primanafisman/THESIS_FULL-BRIDGE-DC-MOTOR-CONTROLLER/README.md

# Hi there

These are prima's thesis.

I'm working at Fullbridge DC Motor Controller. Create model, hardware, and firmware to controll the steering DC Motor

Let's have a look!

Any further improvements are always widthly open
