primanafisman/THESIS_FULL-BRIDGE-DC-MOTOR-CONTROLLER/Dokumen/foto/250pwm.png

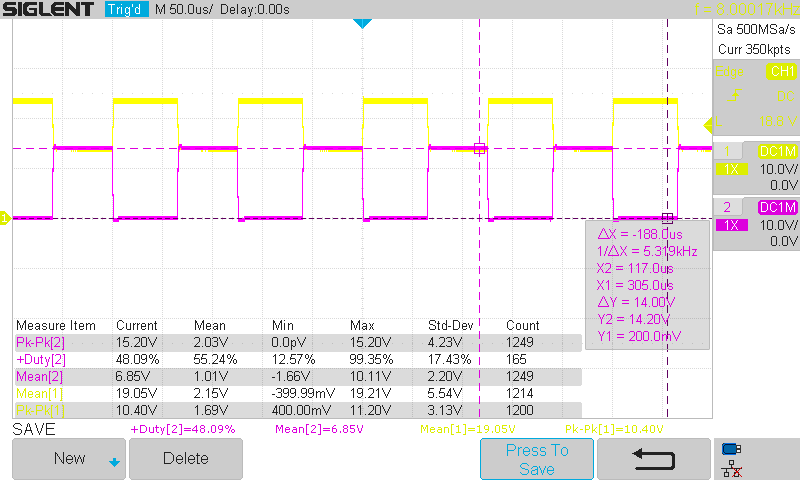
Dokumen/foto/250pwm.png
