primanafisman/THESIS_FULL-BRIDGE-DC-MOTOR-CONTROLLER/Dokumen/foto/PNG250.png

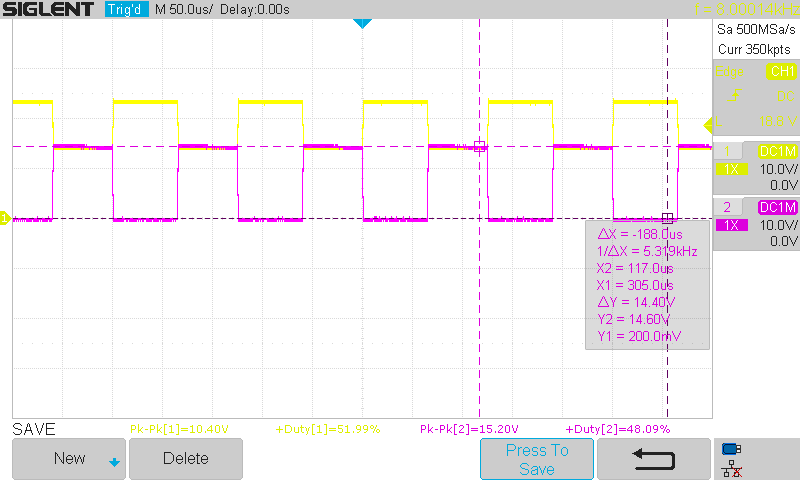
Dokumen/foto/PNG250.png
