primanafisman/THESIS_FULL-BRIDGE-DC-MOTOR-CONTROLLER/Dokumen/foto/SDS00001.png

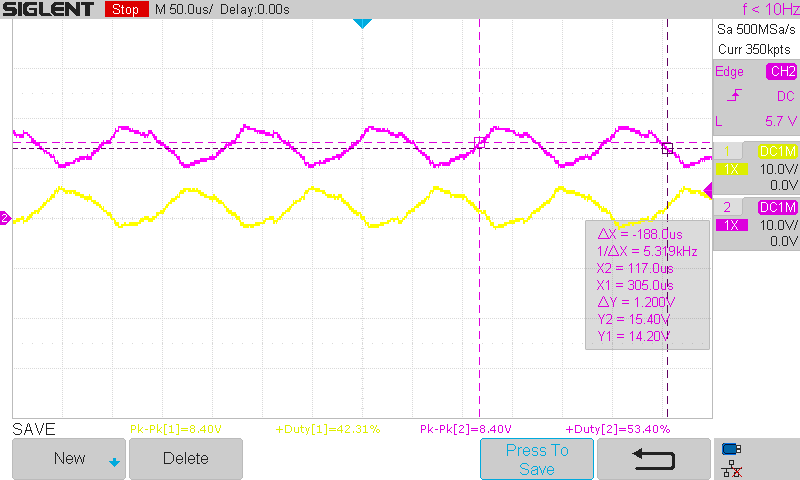
Dokumen/foto/SDS00001.png
