primanafisman/THESIS_FULL-BRIDGE-DC-MOTOR-CONTROLLER/Dokumen/foto/SDS00002.png

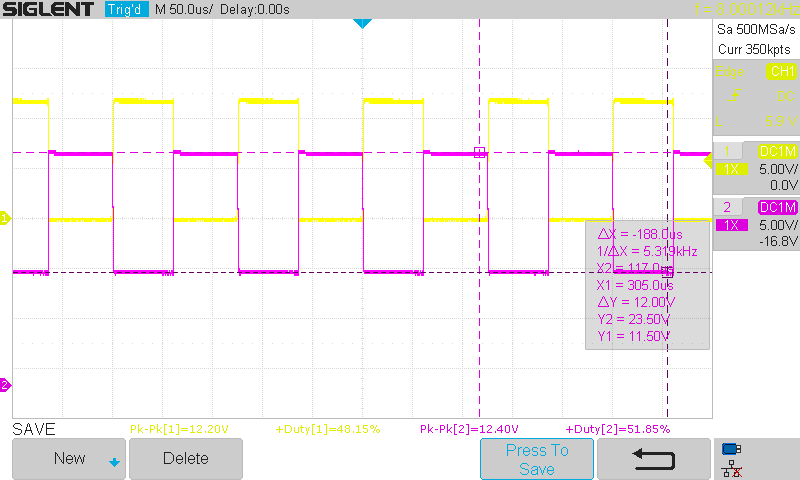
Dokumen/foto/SDS00002.png
