primanafisman/THESIS_FULL-BRIDGE-DC-MOTOR-CONTROLLER/Controller 48V 20A bobokVer/PCB/Controller48V/B2405S-2W/B2405S-2W.step

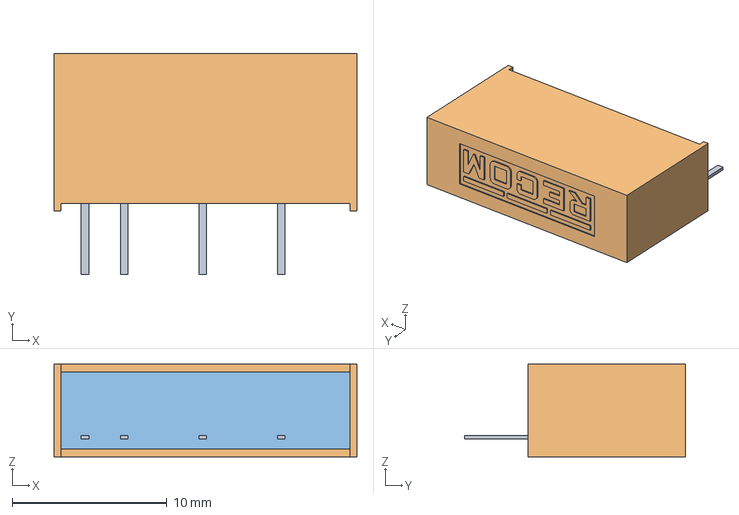
[picture p6: CAD file, 2026-02-03]
Controller 48V 20A bobokVer/PCB/Controller48V/B2405S-2W/B2405S-2W.step
19.6 x 14.3 x 6.00 mm
