primanafisman/THESIS_FULL-BRIDGE-DC-MOTOR-CONTROLLER/Controller 48V 20A bobokVer/PCB/Controller48V/BS1212S/SIP4_B_S-1WR3_MNS.step

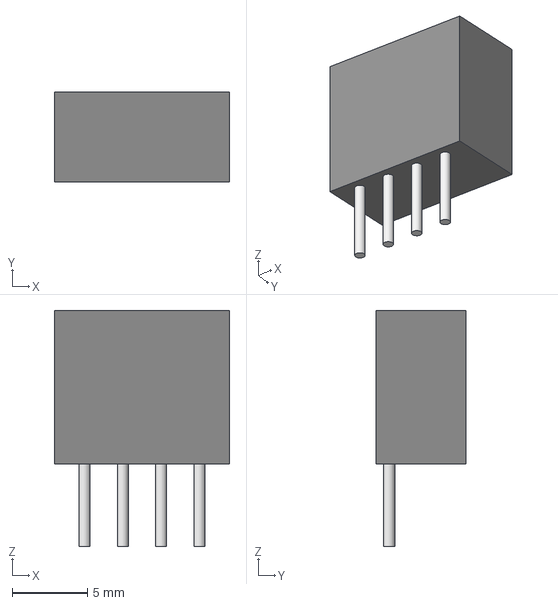
[picture p7: CAD file, 2026-02-03]
Controller 48V 20A bobokVer/PCB/Controller48V/BS1212S/SIP4_B_S-1WR3_MNS.step
11.6 x 5.99 x 15.6 mm
