primanafisman/THESIS_FULL-BRIDGE-DC-MOTOR-CONTROLLER/Controller 48V 20A bobokVer/PCB/Controller48V/TLP350/TLP350.step

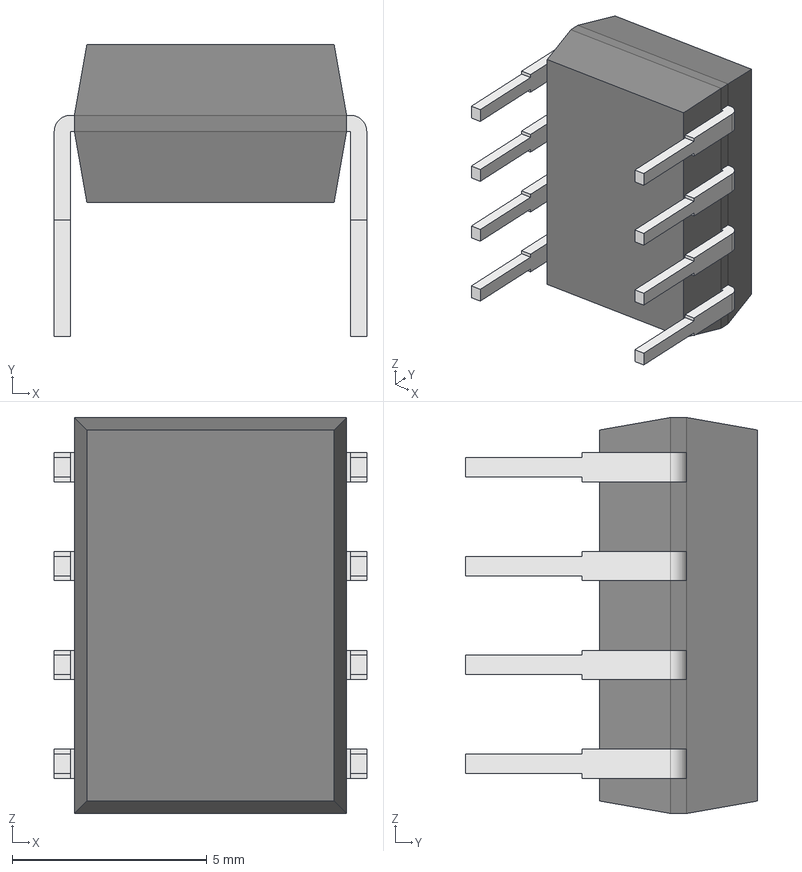
[picture p8: CAD file, 2026-02-03]
Controller 48V 20A bobokVer/PCB/Controller48V/TLP350/TLP350.step
8.04 x 7.51 x 10.2 mm
Body001 (Mirror #1) x 5
