primanafisman/THESIS_FULL-BRIDGE-DC-MOTOR-CONTROLLER/Controller 48V 20A bobokVer/PCB/PrechRes/PrechRes/resistor_100w_aluminum_finned.stp

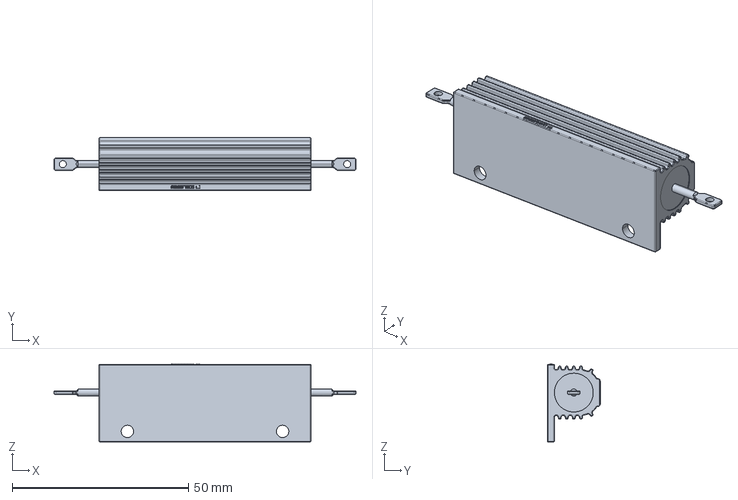
[picture p9: CAD file, 2026-02-03]
Controller 48V 20A bobokVer/PCB/PrechRes/PrechRes/resistor_100w_aluminum_finned.stp
85.6 x 15.1 x 22.1 mm
