primanafisman/THESIS_FULL-BRIDGE-DC-MOTOR-CONTROLLER/Controller 48V 20A bobokVer/PCB/PrechRes/PrechRes/VOM1271/VOM1271T.step

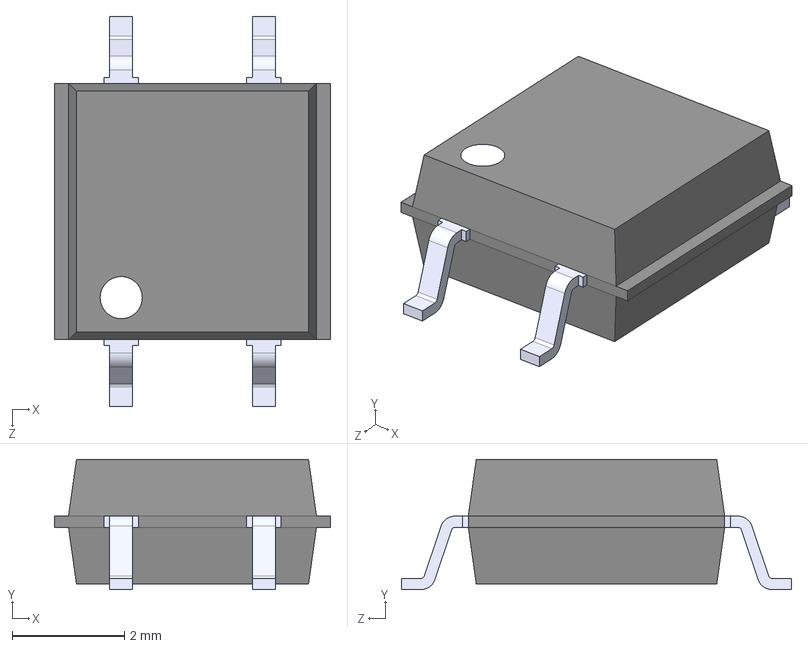
[picture p10: CAD file, 2026-02-03]
Controller 48V 20A bobokVer/PCB/PrechRes/PrechRes/VOM1271/VOM1271T.step
4.92 x 2.32 x 6.95 mm
