primanafisman/THESIS_FULL-BRIDGE-DC-MOTOR-CONTROLLER/Controller 48V 20A bobokVer/PCB/Controller48V/P_16,4x15,8x34,8.STEP

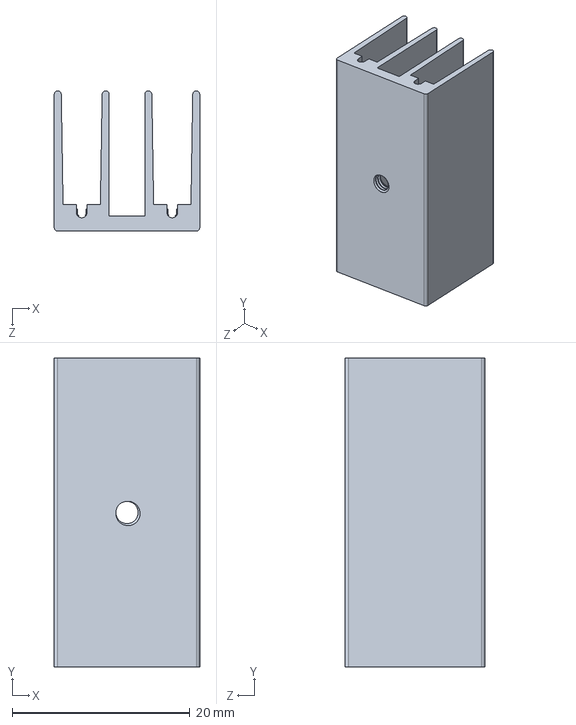
[picture p11: CAD file, 2026-02-03]
Controller 48V 20A bobokVer/PCB/Controller48V/P_16,4x15,8x34,8.STEP
16.4 x 34.8 x 15.8 mm
