primanafisman/THESIS_FULL-BRIDGE-DC-MOTOR-CONTROLLER/Controller 48V 20A bobokVer/PCB/PrechRes/PrechRes/PrechResv2.step

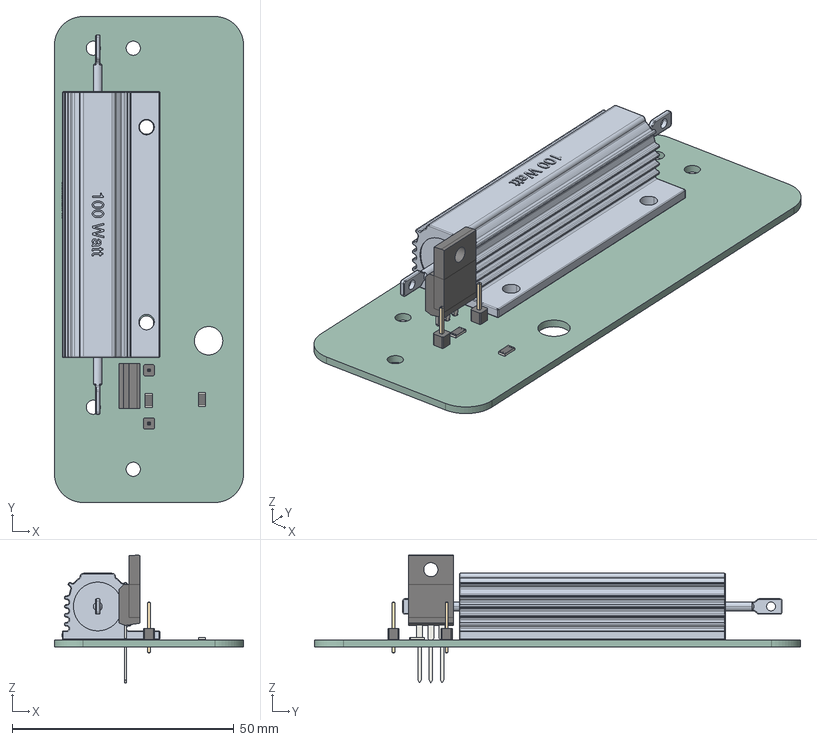
[picture p12: CAD file, 2026-02-03]
Controller 48V 20A bobokVer/PCB/PrechRes/PrechRes/PrechResv2.step
42.7 x 109.7 x 28.9 mm
PinHeader_1x01_P2.54mm_Vertical x 2
resistor_100w_aluminum_finned
R_1206_3216Metric x 2
TO-220F-3_Vertical
PrechResv2_PCB
