primanafisman/THESIS_FULL-BRIDGE-DC-MOTOR-CONTROLLER/Controller 48V 20A bobokVer/PCB/Controller48V/ControlMikon.step

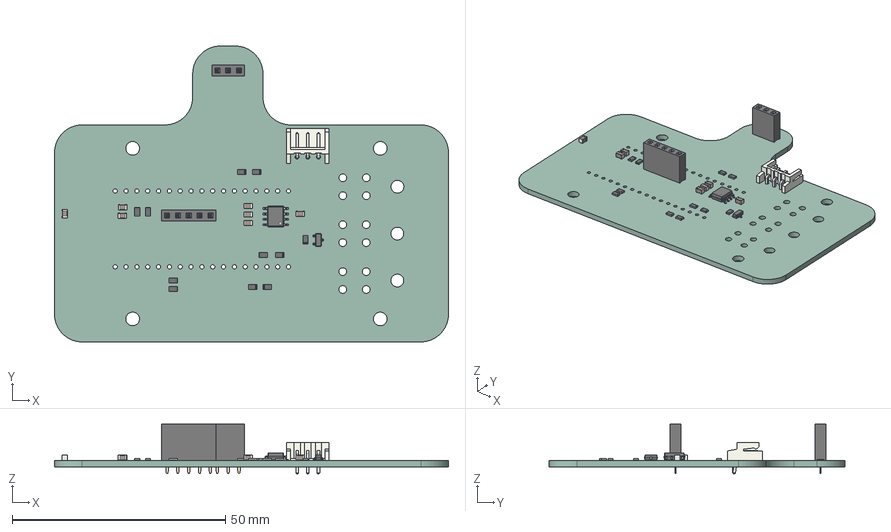
[picture p13: CAD file, 2026-02-03]
Controller 48V 20A bobokVer/PCB/Controller48V/ControlMikon.step
92.4 x 69.4 x 11.7 mm
C_0805_2012Metric x 7
R_0805_2012Metric x 11
SOT-23
PinSocket_1x03_P2.54mm_Vertical
PinSocket_1x05_P2.54mm_Vertical
SOIC-8_3.9x4.9mm_P1.27mm
JST_EH_S3B-EH_1x03_P2.50mm_Horizontal
ControlMikon_PCB
