primanafisman/THESIS_FULL-BRIDGE-DC-MOTOR-CONTROLLER/Controller 48V 20A bobokVer/PCB/Controller48V/C_TO-220x2_36,5x17x25.STEP

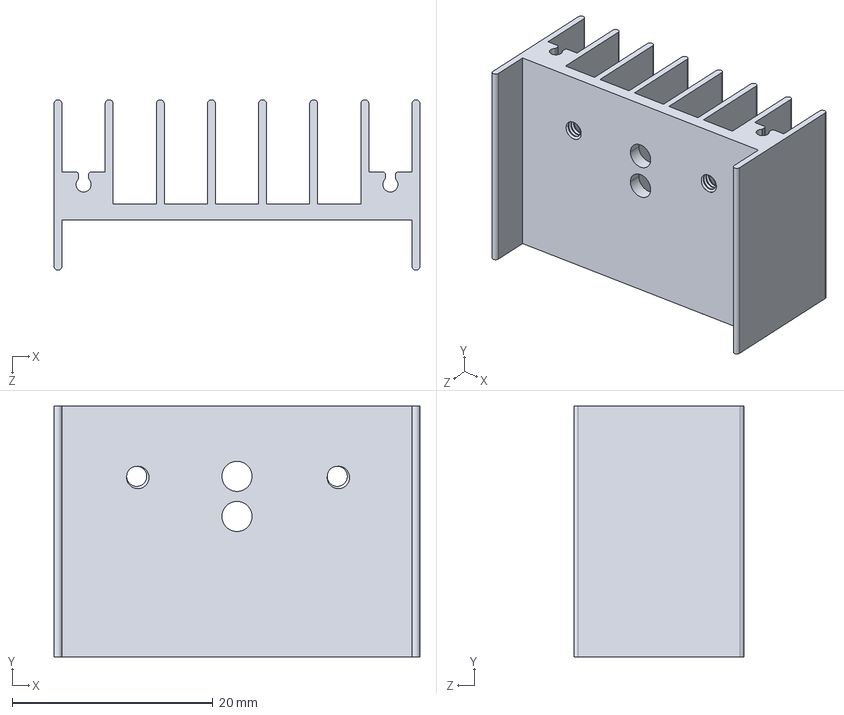
[picture p14: CAD file, 2026-02-03]
Controller 48V 20A bobokVer/PCB/Controller48V/C_TO-220x2_36,5x17x25.STEP
36.5 x 25.0 x 17.0 mm
