primanafisman/THESIS_FULL-BRIDGE-DC-MOTOR-CONTROLLER/Controller 48V 20A bobokVer/PCB/Controller48V/Heatsink_60x20x40.STEP

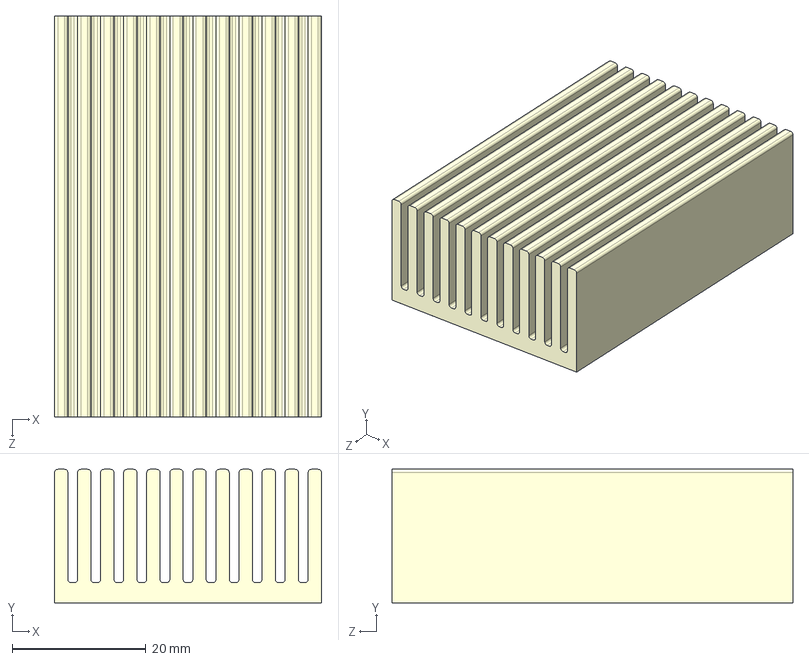
[picture p15: CAD file, 2026-02-03]
Controller 48V 20A bobokVer/PCB/Controller48V/Heatsink_60x20x40.STEP
40.0 x 20.0 x 60.0 mm
