primanafisman/THESIS_FULL-BRIDGE-DC-MOTOR-CONTROLLER/Controller 48V 20A bobokVer/PCB/PrechRes/PrechRes/gerberPrechRes/PrechResv2.pdf

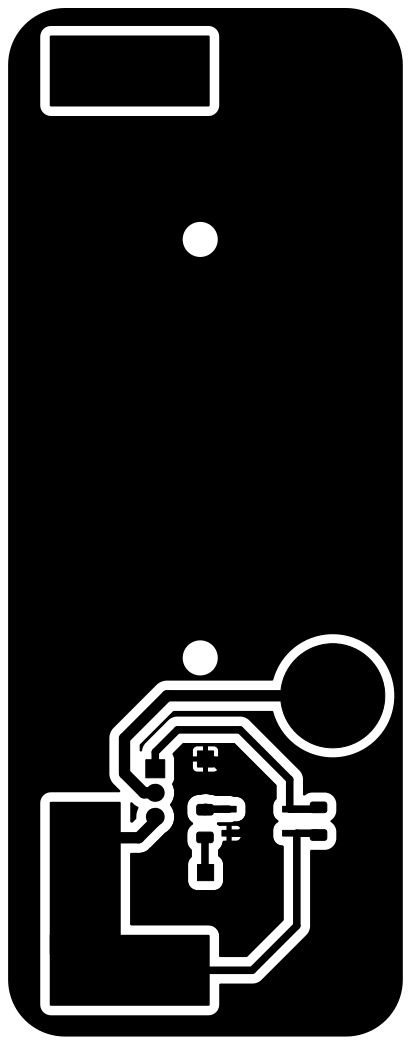
[picture p16: page 1]

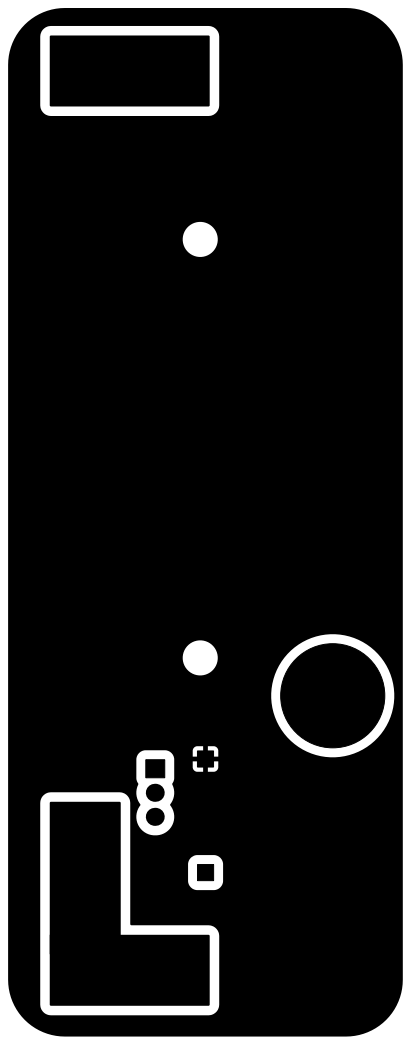
[picture p17: page 2]

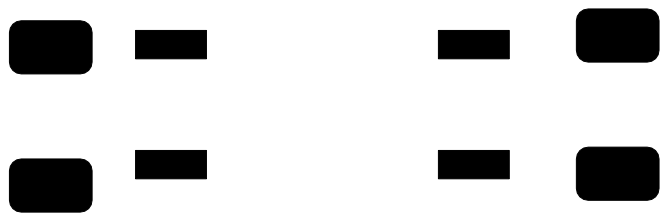
[picture p18: page 3]

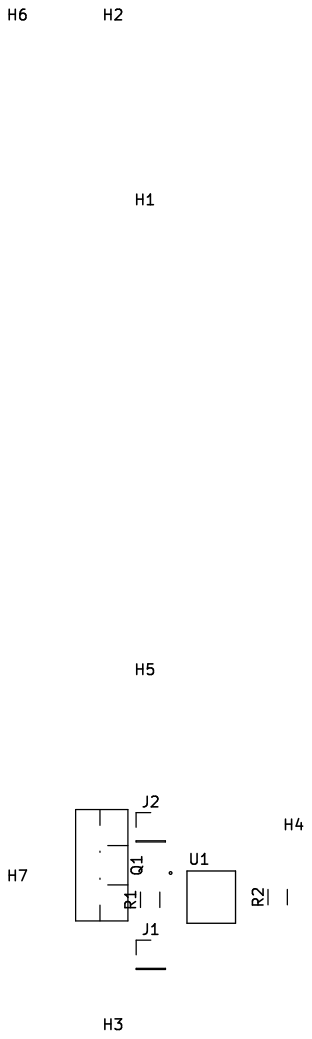
[picture p19: page 5]

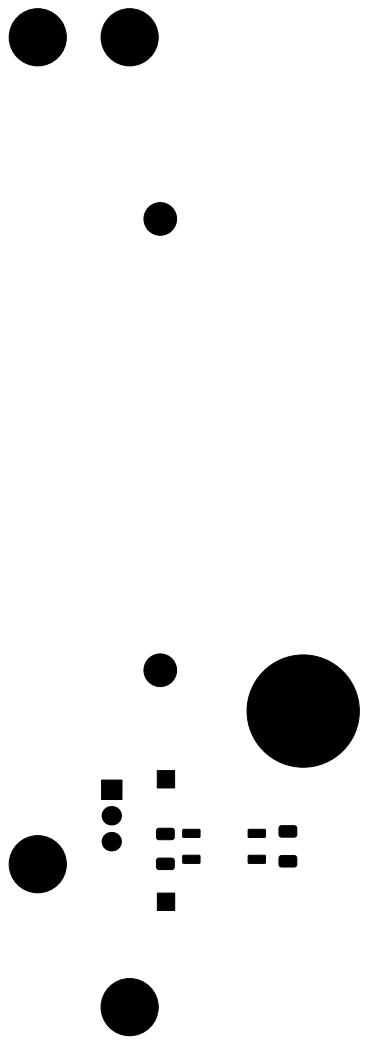
[picture p20: page 7]

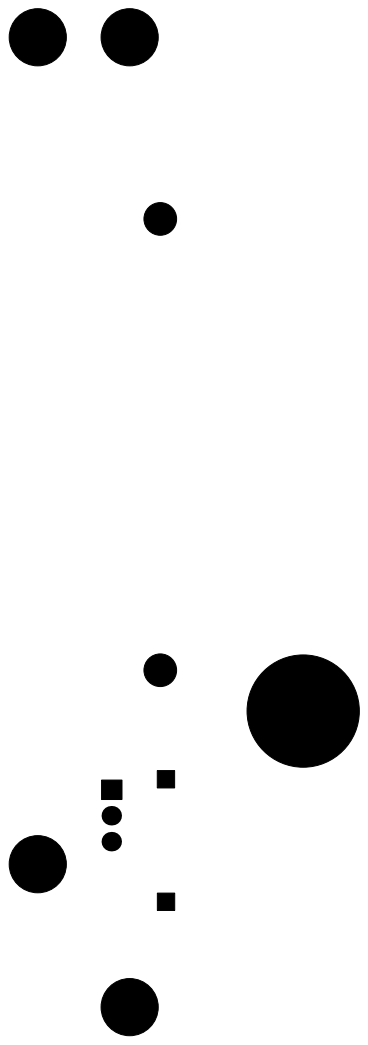
[picture p21: page 8]

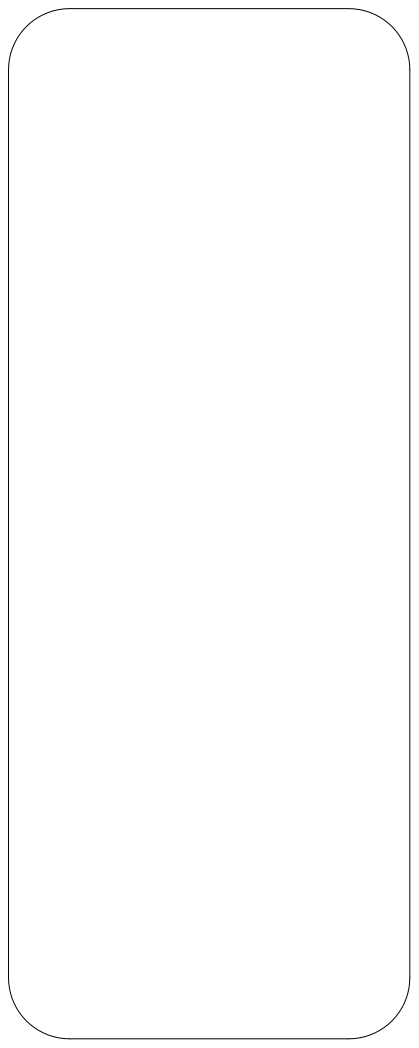
[picture p22: page 9]
