primanafisman/THESIS_FULL-BRIDGE-DC-MOTOR-CONTROLLER/Controller 48V 20A bobokVer/PCB/ControlMikon/ControlMikon.kicad_pcb

## KiCad design Controller 48V 20A bobokVer/PCB/ControlMikon/ControlMikon.kicad_pcb (2026-02-03)

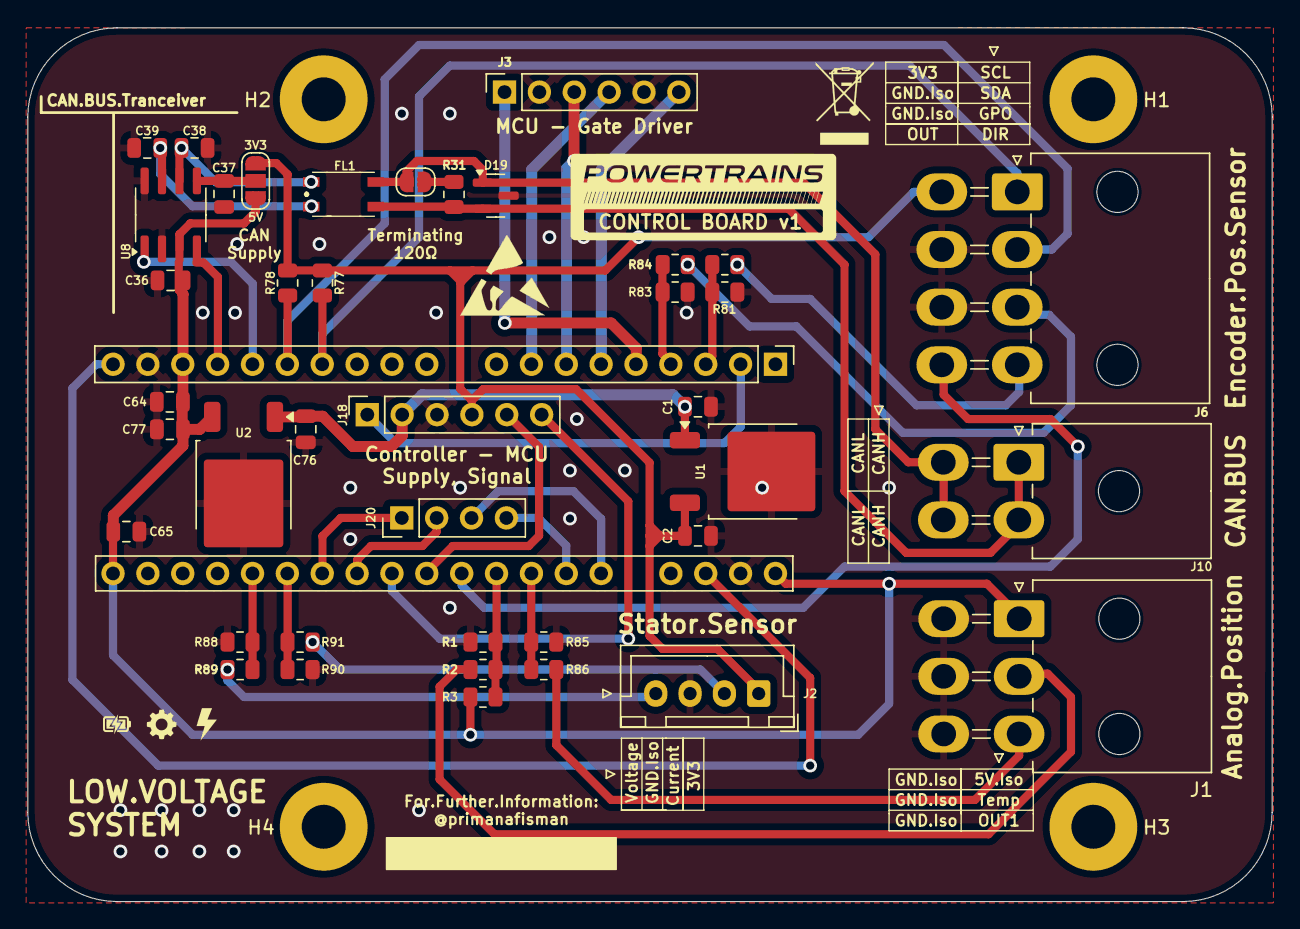
[picture p23: board ControlMikon.kicad_pcb from above]

Board: 2 copper layers, 90.7 x 63.7 mm, 45 parts (0 on the bottom side), 39 nets.

Parts:
C1, C76: 330nF; C_0805_2012Metric
C2, C64, C65, C77: 100nF; C_0805_2012Metric
C36, C37: 1uF; C_0805_2012Metric
C38, C39: 220pf; C_0805_2012Metric
D19: PESD1CAN; SOT-23
FL1: DLW43MH201XK2K; DLW43
H1, H2, H3, H4: MountingHole; MountingHole_3.2mm_M3_Pad
J1: AnalogPosition; Molex_Mini-Fit_Jr_5569-06A2_2x03_P4.20mm_Horizontal
J2: From Current & Voltage Sense; JST_XH_B4B-XH-A_1x04_P2.50mm_Vertical
J3: Conn_01x06; PinSocket_1x06_P2.54mm_Vertical
J5: Selector Termination; SolderJumper-2_P1.3mm_Open_RoundedPad1.0x1.5mm
J6: Conn_01x08; Molex_Mini-Fit_Jr_5569-08A2_2x04_P4.20mm_Horizontal
J10: CANBUS; Molex_Mini-Fit_Jr_5569-04A2_2x02_P4.20mm_Horizontal
J18: Input Power; PinSocket_1x06_P2.54mm_Vertical
J20: AnalogPosition; PinHeader_1x04_P2.54mm_Vertical
JP5: Logic Level; SolderJumper-3_P1.3mm_Open_RoundedPad1.0x1.5mm_NumberLabels
R1, R2, R3, R77, R78, R81, R82, R83, R84, R85, R86: 1k; R_0805_2012Metric
R31: 120; R_0805_2012Metric
R88, R90: 3k3; R_0805_2012Metric
R89, R91: 1k8; R_0805_2012Metric
U1, U2: LM78M05_TO252; TO-252-2
U8: MCP2562-H-SN; SOIC-8_3.9x4.9mm_P1.27mm
U23: STM32F103CBTx; STM32F103CBT6

Connections:
3V3: C2.2, J2.1, J6.5, J18.4, JP5.3 (B), R77.1, R78.1, U1.3 (VO)
5VDigital_Isolated: C36.1, C64.1, C65.1, C77.2, J1.1, JP5.1 (A), R3.2, U2.3 (VO), U8.3 (VDD), U23.1 (VBAT), U23.24 (VDD), U23.36 (VDD)
12V_Isolated: C1.2, C76.2, J18.2, U1.1 (VI), U2.1 (VI)
/PRECHARGE_FINISH_TRIG: J18.1, U23.26 (PB13)
Aux1: J18.6, U23.14 (ADC1_IN4)
Aux2: J18.5, U23.15 (ADC1_IN5)
Aux3: R1.2, R2.1, R3.1, U23.17 (ADC1_IN7)
BATTV_Out: J20.1, U23.12 (ADC1_IN2)
CAL_L: C38.1, FL1.4, U8.6 (CANL)
CAN_H: C39.1, FL1.1, U8.7 (CANH)
CAN_H_Out: D19.2, FL1.2, J10.1, J10.2, R31.2
CAN_L_Out: D19.1, FL1.3, J5.1, J10.3, J10.4
CAN_Rx: U8.4 (RXD), U23.46 (CAN_TX)
CAN_Tx: U8.1 (TXD), U23.45 (CAN_RX)
CTRLV_Out: J20.2, U23.13 (ADC1_IN3)
CurrentSensor: R90.2, R91.1, U23.11 (ADC1_IN1)
DIR: R81.2, R82.1, U23.27 (PB14)
FinishLV: J20.4, U23.19 (PB1)
GND_Isolated: C1.1, C2.1, C36.2, C37.2, C38.2, C39.2, C64.2, C65.2, C76.1, C77.1, D19.3, J1.4, J1.5, J1.6, J2.3, J3.2, J3.5, J6.6, J6.7, J18.3, R1.1, R81.1, R83.1, R85.1, R88.1, R90.1, U1.2 (GND), U2.2 (GND), U8.2 (VSS), U8.8 (STBY), U23.8 (VSSA), U23.23 (VSS)
GPO: R83.2, R84.1, U23.28 (PB15)
HIN1_Mikon: J3.1, U23.29 (TIM1_CH1)
HIN2_Mikon: J3.3, U23.31 (TIM1_CH3)
LIN1_Mikon: J3.6, U23.30 (TIM1_CH2)
LIN2_Mikon: J3.4, U23.32 (TIM1_CH4)
unnamed: J1.2, R2.2
unnamed: J1.3, R86.2
unnamed: J2.2, R91.2
unnamed: J2.4, R89.2
unnamed: J5.2, R31.1
unnamed: J6.3, R84.2
unnamed: J6.4, R82.2
unnamed: C37.1, JP5.2 (C), U8.5 (Vio)
unnamed: U23.9 (VDDA), U23.48 (VDD)
Out: J6.8, U23.16 (ADC1_IN6)
Out1: R85.2, R86.1, U23.18 (ADC1_IN8)
Ready: J20.3, U23.20 (PB2)
SCL: J6.1, R77.2, U23.42 (I2C1_SCL)
SDA: J6.2, R78.2, U23.43 (I2C1_SDA)
VoltageSensor: R88.2, R89.1, U23.10 (ADC1_IN0)
