primanafisman/THESIS_FULL-BRIDGE-DC-MOTOR-CONTROLLER/Controller 48V 20A bobokVer/PCB/PrechRes/PrechRes/PrechRes.kicad_pcb

## KiCad design Controller 48V 20A bobokVer/PCB/PrechRes/PrechRes/PrechRes.kicad_pcb (2026-02-03)

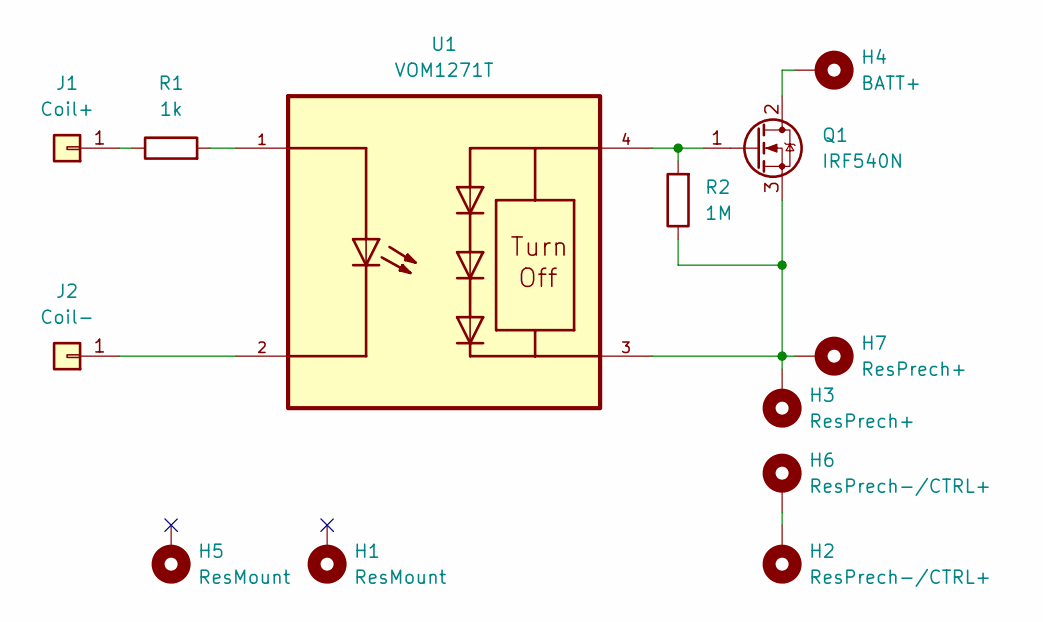
[picture p24: schematic PrechRes.kicad_sch]

Parts:
H1, H5: ResMount; MountingHole_3.2mm_M3
H2, H6: ResPrech-/CTRL+; MountingHole_3.2mm_M3_DIN965_Pad
H3, H7: ResPrech+; MountingHole_3.2mm_M3_DIN965_Pad
H4: BATT+; MountingHole_6.4mm_M6_DIN965_Pad
J1: Coil+; PinHeader_1x01_P2.54mm_Vertical
J2: Coil-; PinHeader_1x01_P2.54mm_Vertical
Q1: IRF540N; TO-220F-3_Horizontal_TabDown
R1: 1k; R_1206_3216Metric
R2: 1M; R_1206_3216Metric
U1: VOM1271T; SOIC254P695X242-4N

Connections:
unnamed: H2.1, H6.1
unnamed: J1.1, R1.1
unnamed: J2.1, U1.2
unnamed: H4.1, Q1.2 (D)
unnamed: Q1.1 (G), R2.2, U1.4
unnamed: H3.1, H7.1, Q1.3 (S), R2.1, U1.3
unnamed: R1.2, U1.1

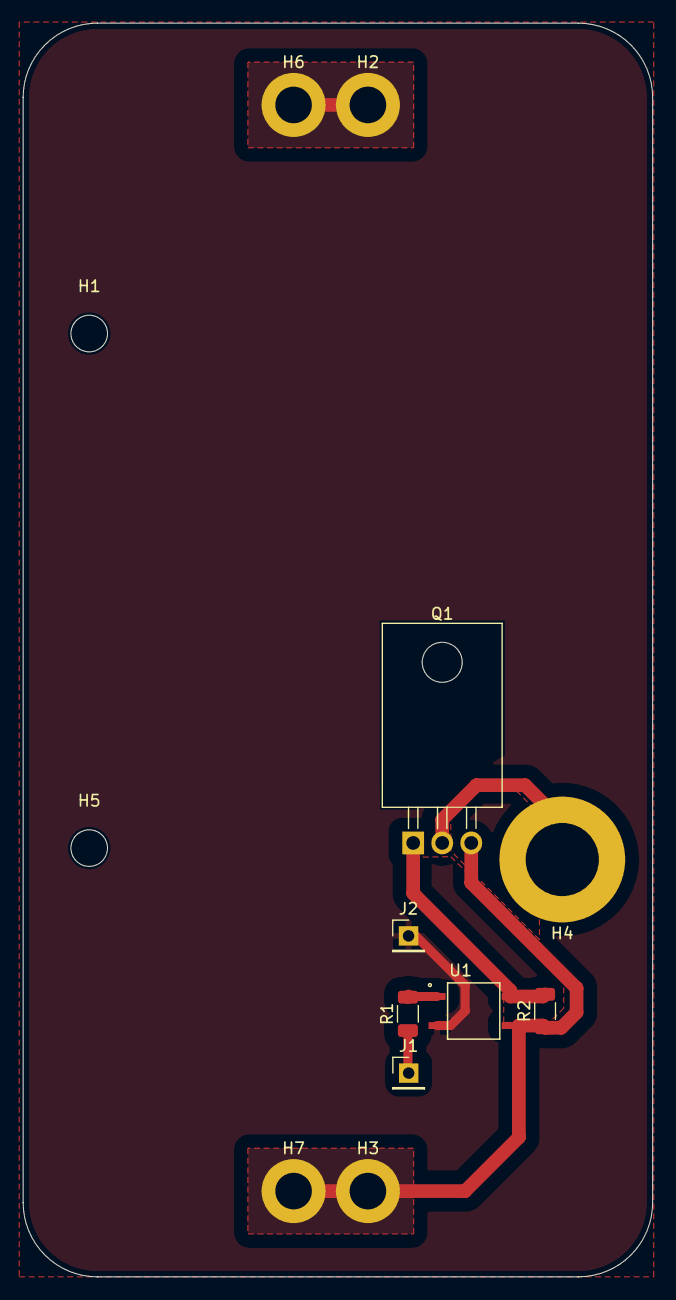
[picture p25: board PrechRes.kicad_pcb from above]

Board: 2 copper layers, 55.1 x 109.7 mm, 13 parts (0 on the bottom side), 7 nets.
