primanafisman/THESIS_FULL-BRIDGE-DC-MOTOR-CONTROLLER/Controller 48V 20A bobokVer/PCB/Controller48V/Controller48V - Copy.kicad_pcb

## KiCad design Controller 48V 20A bobokVer/PCB/Controller48V/Controller48V - Copy.kicad_pcb (2026-02-03)

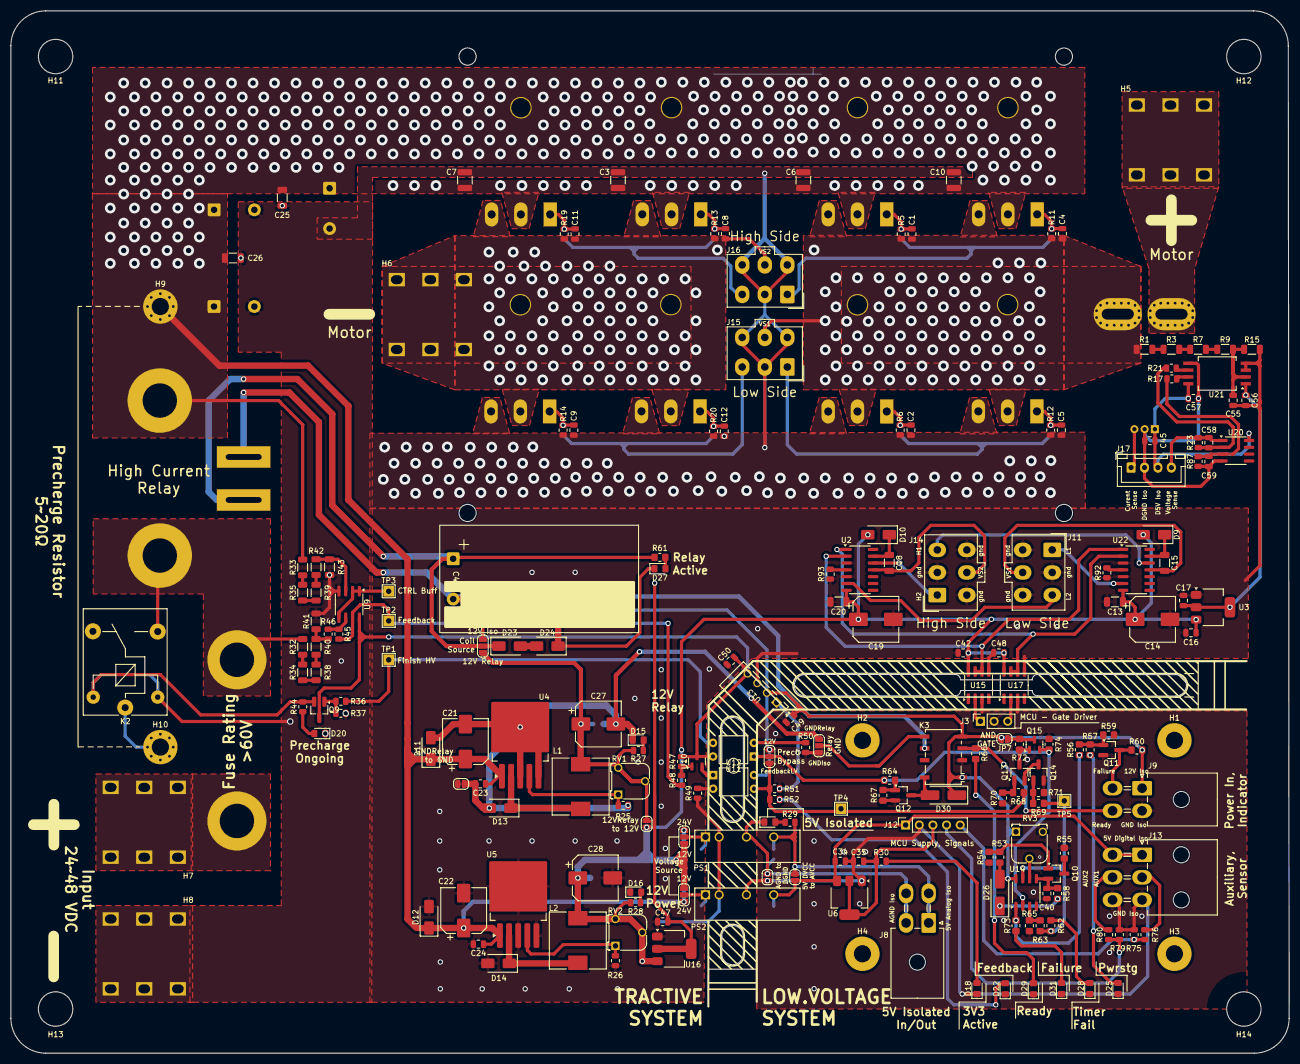
[picture p26: board Controller48V - Copy.kicad_pcb from above]

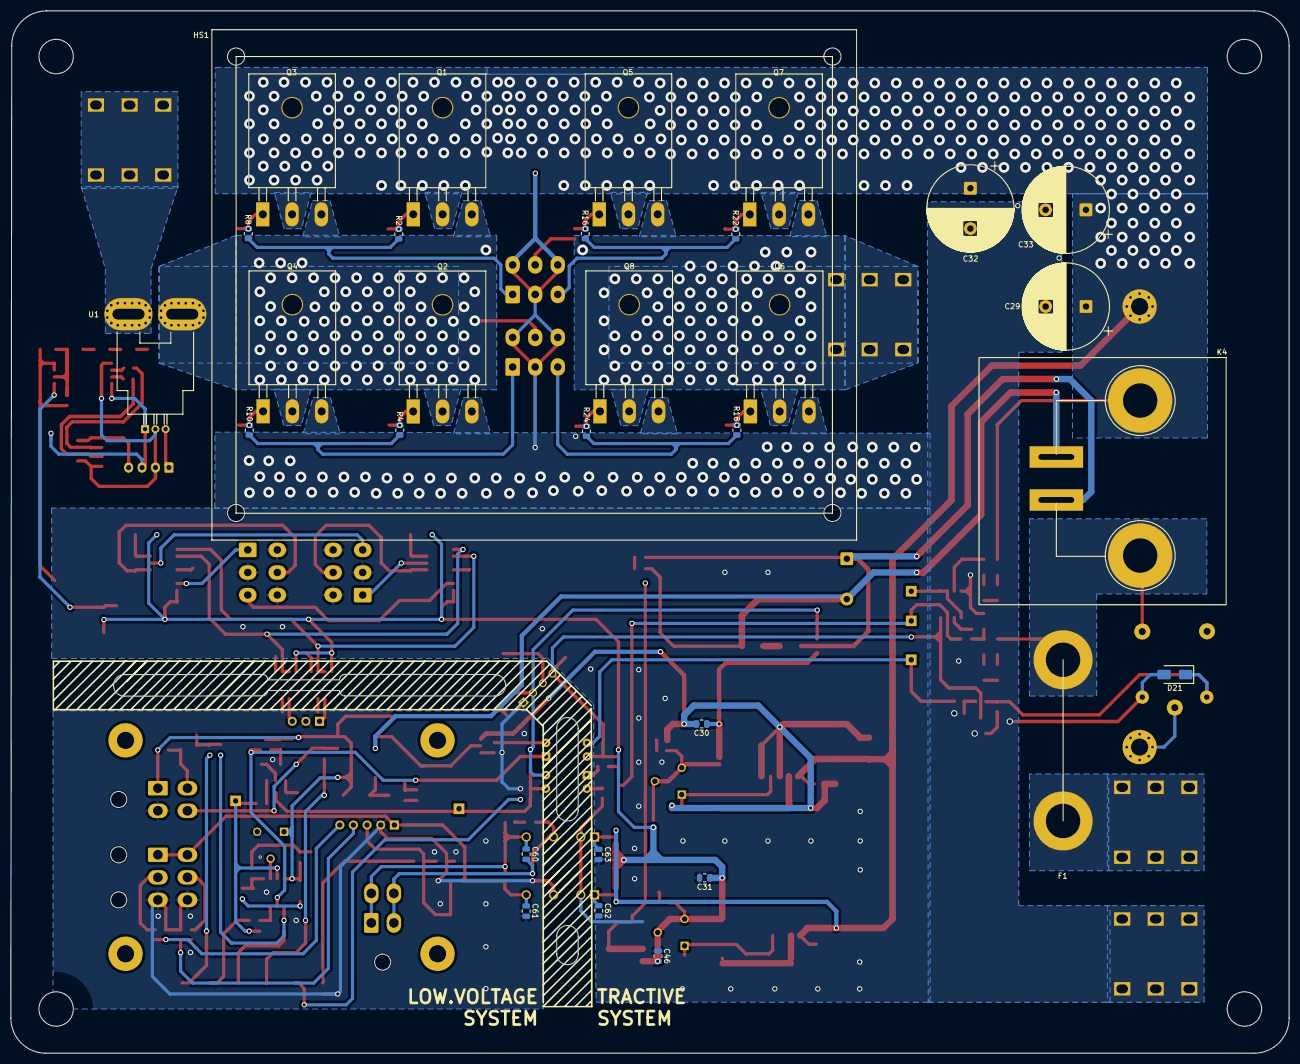
[picture p27: board Controller48V - Copy.kicad_pcb from below]

Board: 2 copper layers, 237.9 x 194.0 mm, 239 parts (31 on the bottom side), 121 nets.

Parts:
C1, C2, C4, C5, C8, C9, C11, C12, C23, C24, C42, C48, C56, C57: 100nF; C_0805_2012Metric
C3, C6, C7, C10: 10uF; C_1210_3225Metric
C13, C20, C25, C26: 100nF; C_1206_3216Metric
C14, C19: 100uF; CP_Elec_8x10
C15, C18: 2.2uF; C_1206_3216Metric
C16, C17, C34, C35, C46, C47, C60, C61: 10uF; C_0805_2012Metric
C21, C22, C27, C28: 470uF; CP_Elec_8x10
C29: 470uF/100V; CP_Radial_D16.0mm_P7.50mm
C30, C31: 220uF; C_0805_2012Metric
C32: 220uF/100V; CP_Radial_D16.0mm_P7.50mm
C33: 100uF/100V; CP_Radial_D16.0mm_P7.50mm
C40: 47uF; C_0805_2012Metric
C41: 4700uF; Capacitor_Radial_Vertical_18mm
C45: 220pf; C_0805_2012Metric
C49, C50, C62, C63: 2.2uF; C_0805_2012Metric
C55: 330pF; C_0805_2012Metric
C58, C59: 100pF; C_0805_2012Metric
D9, D10: UF4007; D_SMA
D11, D12, D13, D14: 1N5822; D_SMA
D15: LED_12Relay; LED_0805_2012Metric_Pad1.15x1.40mm_HandSolder
D16: LED_12V; LED_0805_2012Metric_Pad1.15x1.40mm_HandSolder
D17, D18, D20, D22, D27: LED; LED_0805_2012Metric_Pad1.15x1.40mm_HandSolder
D21: 1N4007; D_SMA
D23: D_Schottky; D_SMA
D24: D_Zener; D_SMA
D25: PWRSTG; LED_0805_2012Metric_Pad1.15x1.40mm_HandSolder
D26, D30: 1N4007; D_SMA_Handsoldering
D28: TIMER; LED_0805_2012Metric_Pad1.15x1.40mm_HandSolder
D29: Ready ON; LED_0805_2012Metric_Pad1.15x1.40mm_HandSolder
D31: Failure; LED_0805_2012Metric_Pad1.15x1.40mm_HandSolder
F1: Fuse; Fuse_L30mm
H1, H2, H3, H4: MountingHole; MountingHole_3.2mm_M3_Pad
H5: OUT+; TerminalSMD_M5
H6: OUT-; TerminalSMD_M5
H7: BATT+; TerminalSMD_M5
H8: BATT-; TerminalSMD_M5
H9: Prech_Res-; MountingHole_3.2mm_M3_Pad_Via
H10: Prech_Res+; MountingHole_3.2mm_M3_Pad_Via
H11, H12, H13, H14: MountingHole; MountingHole_6.4mm_M6
HS1: Heatsink; Heatsink_120x95x30mm
J3: toMCU; PinSocket_1x03_P2.54mm_Vertical
J8: AnalogPosition; Molex_Mini-Fit_Jr_5569-04A2_2x02_P4.20mm_Horizontal
J9: OutECU; Molex_Mini-Fit_Jr_5569-04A2_2x02_P4.20mm_Horizontal
J11, J15: Swiching1; Molex_Mini-Fit_Jr_5566-06A_2x03_P4.20mm_Vertical
J12: Out Power; PinSocket_1x05_P2.54mm_Vertical
J13: AuxSensor; Molex_Mini-Fit_Jr_5569-06A2_2x03_P4.20mm_Horizontal
J14, J16: Swiching2; Molex_Mini-Fit_Jr_5566-06A_2x03_P4.20mm_Vertical
J17: To mikon; JST_XH_B4B-XH-A_1x04_P2.50mm_Vertical
JP1: Relayto12V; SolderJumper-2_P1.3mm_Open_RoundedPad1.0x1.5mm
JP2: GNDRelaytoGND; SolderJumper-2_P1.3mm_Open_RoundedPad1.0x1.5mm
JP3, JP4: Iso_Source; SolderJumper-3_P1.3mm_Open_RoundedPad1.0x1.5mm_NumberLabels
JP6: Precharge_Baypass; SolderJumper-3_P1.3mm_Open_RoundedPad1.0x1.5mm_NumberLabels
JP7: AND GATE; SolderJumper-2_P1.3mm_Open_RoundedPad1.0x1.5mm
JP8: AnalogtoDigital; SolderJumper-2_P1.3mm_Open_RoundedPad1.0x1.5mm
JP9: GNDAnalogtoDigital; SolderJumper-2_P1.3mm_Open_RoundedPad1.0x1.5mm
JP10: Relay_Source; SolderJumper-3_P1.3mm_Open_RoundedPad1.0x1.5mm_NumberLabels
JP11: GNDRelay_Source; SolderJumper-3_P1.3mm_Open_RoundedPad1.0x1.5mm_NumberLabels
K2: Relay_SPDT; Relay_SPDT_SANYOU_SRD_Series_Form_C
K3: G6K-2F-Y; Relay_DPDT_Omron_G6K-2F-Y
K4: High Current Relay; MainRelay100A
L1, L2: 470uH; L_10.4x10.4_H4.8
PS1, PS2: B1205S-2W; B2405S-2W
Q1, Q2, Q3, Q4, Q5, Q6, Q7, Q8: 47N60; TO-247-3_Horizontal_TabDown
Q9, Q10: AO3401A; SOT-23_Handsoldering
Q11, Q12, Q13, Q14: AO3404; SOT-23_Handsoldering
Q15: AO3401A; SOT-23
R1, R3: 47k; R_1206_3216Metric
R2, R4, R8, R10, R16, R18, R22, R24: 10; R_0805_2012Metric
R5, R6, R11, R12, R13, R14, R19, R20: 47k; R_0805_2012Metric
R7, R9: 1k; R_1206_3216Metric
R15, R35, R39, R41, R42, R43: 10k; R_1206_3216Metric
R17, R21, R23, R37, R47, R51, R87, R92, R93: 10k; R_0805_2012Metric
R25, R26: 330; R_0805_2012Metric
R27, R28, R29, R30, R44, R46, R49, R50, R52, R75, R76, R79, R80: 1k; R_0805_2012Metric
R32, R33: 100k; R_1206_3216Metric
R34, R38, R40: 20k; R_1206_3216Metric
R36, R48: 100; R_0805_2012Metric
R45: 100k; R_0805_2012Metric
R53, R57, R61, R64: 1k; R_0805_2012Metric_Pad1.20x1.40mm_HandSolder
R54: 10k; R_0805_2012Metric_Pad1.20x1.40mm_HandSolder
R55, R56, R68, R69: 100; R_0805_2012Metric_Pad1.20x1.40mm_HandSolder
R58: 100k; R_0805_2012Metric_Pad1.20x1.40mm_HandSolder
R59, R60, R67, R70, R71, R72, R74: 10K; R_0805_2012Metric_Pad1.20x1.40mm_HandSolder
R62, R63, R65, R66, R73: 1K; R_0805_2012Metric_Pad1.20x1.40mm_HandSolder
RV1, RV2: 10k; Potentiometer_Runtron_RM-065_Vertical
RV3: 10K; Potentiometer_Runtron_RM-065_Vertical
TP1: FinishHV; TestPoint_THTPad_2.0x2.0mm_Drill1.0mm
TP2, TP3: TestPoint; TestPoint_THTPad_2.0x2.0mm_Drill1.0mm
TP4: FinishLV; TestPoint_THTPad_2.0x2.0mm_Drill1.0mm
TP5: TIMER; TestPoint_THTPad_2.0x2.0mm_Drill1.0mm
U1: ACS758xCB-050B-PFF; Allegro_CB_PFF
U2, U22: IR21844; SOIC-14_3.9x8.7mm_P1.27mm
U3, U16: AMS1117-5.0; SOT-223-3_TabPin2
U4, U5: LM2596HV-ADJ; TO-263-5_TabPin3
U6: AMS1117-3.3; SOT-223-3_TabPin2
U9: TL072; SOIC-8_3.9x4.9mm_P1.27mm
U10: AO3404; SOT-23
U11, U12: PC817; DIP-4_W7.62mm
U13: B1212S-1WR3; SIP4_B_S-1WR3_MNS
U14: LM358; SO-8_3.9x4.9mm_P1.27mm
U15, U17: TLP350; SOP-8_3.76x4.96mm_P1.27mm
U20: LM358; SOIC-8_3.9x4.9mm_P1.27mm
U21: ACPL-C87A; SSO-8_6.8x5.9mm_P1.27mm_Clearance8mm

Connections:
3V3: C35.2, J12.3, R30.1, U6.2 (VO)
5V: C47.2, U16.2 (VO)
5VDigital_Isolated: C34.2, C61.1, J12.1, J13.1, J13.4, JP8.2 (B), PS2.6 (+VOUT), U6.3 (VI)
5VSense_Isolated: C45.1, C57.2, J17.3, U1.1 (VCC), U20.8 (V+), U21.8 (VDD2)
5V_Isolated: C60.1, J8.1, J8.3, JP8.1 (A), PS1.6 (+VOUT), R29.1
5V_Opamp: C17.2, C56.1, U3.2 (VO), U21.1 (VDD1)
12V: C13.1, C14.1, C16.2, C19.1, C20.1, C28.1, C31.1, C42.1, C46.2, C48.1, D9.2 (A), D10.2 (A), JP1.2 (B), JP3.1 (A), JP4.1 (A), L2.2, R28.1, RV2.2, RV2.3, U2.7 (VCC), U3.3 (VI), U15.8 (VCC), U16.3 (VI), U17.8 (VCC), U22.7 (VCC)
12V_Isolated: C49.2, D26.2 (A), D30.1 (K), J9.1, JP6.3 (B), JP7.2 (B), JP10.3 (B), K3.1, K3.4, R53.1, R60.1, RV3.1, U12.4, U13.2 (VIN), U14.8 (V+)
12V_P: C50.1, Q9.3 (D), R47.2, U9.8 (V+), U10.3, U11.4, U13.4 (+VO)
12V_Relay: C27.1, C30.1, JP1.1 (A), JP10.1 (A), L1.2, R27.1, RV1.2, RV1.3
24V: C3.1, C6.1, C7.1, C10.1, C21.1, C22.1, C23.1, C24.1, C25.1, C26.1, C29.1, C32.1, C33.1, D11.1 (K), D12.1 (K), H9.1, JP3.3 (B), JP4.3 (B), K4.1, Q1.2 (D), Q3.2 (D), Q5.2 (D), Q7.2 (D), R33.1, U4.1 (VIN), U5.1 (VIN)
/Power Supply and Regulator/BATT+: F1.2, K2.3, K4.3, R32.1
/Power Supply and Regulator/Coil+: C41.1, D23.1 (K), JP10.2 (C), K4.5, R61.1
Aux1: J12.5, R75.1, R76.2
Aux2: J12.4, R79.2, R80.1
BATT_Div: R40.2, R41.2, R46.1
CTRL_Div: R42.2, R43.2, U9.3 (+)
Failure: R56.1, R73.1, U14.1
Failure_Out: J9.3, Q11.3 (D), R60.2
Feedback: R45.2, R48.1, TP2.1, U9.7
FeedbackLV: JP6.1 (A), R51.2, R52.2, R68.1, TP4.1, U12.3
FinishHV: R36.1, TP1.1, U11.3
FinishLV: JP6.2 (C), Q15.2 (S), R64.1, R74.1, U11.1, U14.2 (-)
GDNSense_Isolated: C45.2, C57.1, C59.1, J17.2, R87.1, U1.2 (GND), U20.4 (V-), U21.5 (GND2)
GNDREF_Isolated: C60.2, D17.1 (K), J8.2, J8.4, JP9.1 (A), PS1.4 (-VOUT)
GNDREF_Relay: C21.2, C23.2, C27.2, C30.2, D11.2 (A), D13.2 (A), D15.1 (K), JP2.1 (A), JP11.3 (B), R25.1, U4.3 (GND), U4.5 (~ON/OFF)
GND_Isolated: C34.1, C35.1, C40.2, C49.1, C61.2, D18.1 (K), D22.1 (K), D25.1 (K), D28.1 (K), D29.1 (K), D31.1 (K), J3.2, J9.2, J12.2, J13.3, J13.6, JP9.2 (B), JP11.1 (A), K3.2, PS2.4 (-VOUT), Q11.2 (S), Q12.2 (S), Q14.2 (S), R50.1, R51.1, R54.2, R55.2, R59.2, R65.1, R67.1, R70.2, R71.2, R74.2, R76.1, R79.1, RV3.3, U6.1 (GND), U13.1 (GND), U14.4 (V-), U15.3 (C), U17.3 (C)
H1: J16.1, R2.1, R8.1
H1_Out: J14.3, U22.12 (HO)
H2: J16.3, R16.1, R22.1
H2_Out: J14.1, U2.12 (HO)
HIN_Iso: J3.1, U15.2 (A)
HIN_Out: U2.2 (~SD), U15.6 (VO), U15.7 (VO), U22.1 (IN)
IP+: C1.2, C4.2, J15.5, Q1.3 (S), Q2.2 (D), Q3.3 (S), Q4.2 (D), R1.1, R5.1, R11.1, U1.4 (IP+)
IP-: H5.1, U1.5 (IP-)
L1: J15.1, R4.1, R10.1
L1_Out: J11.1, U22.6 (LO)
L2: J15.3, R18.1, R24.1
L2_Out: J11.3, U2.6 (LO)
LIN_Iso: J3.3, U17.2 (A)
LIN_Out: U2.1 (IN), U17.6 (VO), U17.7 (VO), U22.2 (~SD)
unnamed: C15.1, D9.1 (K), U22.13 (VB)
unnamed: C18.1, D10.1 (K), U2.13 (VB)
unnamed: D13.1 (K), L1.1, U4.2 (OUT)
unnamed: D14.1 (K), L2.1, U5.2 (OUT)
unnamed: D15.2 (A), R27.2
unnamed: D16.2 (A), R28.2
unnamed: D17.2 (A), R29.2
unnamed: D18.2 (A), R30.2
unnamed: D20.2 (A), R44.1
unnamed: D21.1 (K), K2.5, Q9.2 (S), R44.2
unnamed: D22.2 (A), R52.1
unnamed: D23.2 (A), D24.2 (A)
unnamed: D25.2 (A), R57.1
unnamed: D26.1 (K), R58.1
unnamed: D27.2 (A), R61.2
unnamed: D28.2 (A), R62.2
unnamed: D29.2 (A), R66.2
unnamed: D30.2 (A), K3.8, Q12.3 (D)
unnamed: D31.2 (A), R73.2
unnamed: F1.1, H7.1
unnamed: H10.1, K2.1
unnamed: J13.2, R75.2
unnamed: J13.5, R80.2
unnamed: J17.1, U1.3 (VIOUT)
unnamed: C63.1, JP3.2 (C), PS1.1 (+VIN)
unnamed: C62.1, JP4.2 (C), PS2.1 (+VIN)
unnamed: JP7.1 (A), Q15.3 (D), R72.1
unnamed: JP11.2 (C), K3.5
unnamed: C1.1, Q1.1 (G), R2.2, R5.2
unnamed: C2.1, Q2.1 (G), R4.2, R6.2
unnamed: C4.1, Q3.1 (G), R8.2, R11.2
unnamed: C5.1, Q4.1 (G), R10.2, R12.2
unnamed: C8.1, Q5.1 (G), R13.2, R16.2
unnamed: C9.1, Q6.1 (G), R14.2, R18.2
unnamed: C11.1, Q7.1 (G), R19.2, R22.2
unnamed: C12.1, Q8.1 (G), R20.2, R24.2
unnamed: Q9.1 (G), R36.2, R37.2
unnamed: Q10.3 (D), R55.1
unnamed: Q10.1 (G), R53.2, R54.1
unnamed: C40.1, Q10.2 (S), R58.2, U14.5 (+)
unnamed: Q11.1 (G), R56.2, R57.2, R59.1
unnamed: Q12.1 (G), R64.2, R67.2
unnamed: Q13.3 (D), Q15.1 (G), R72.2
unnamed: Q13.1 (G), R68.2, R70.1
unnamed: Q13.2 (S), Q14.3 (D)
unnamed: Q14.1 (G), R69.2, R71.1
unnamed: R1.2, R3.1
unnamed: R3.2, R7.1
unnamed: R7.2, R9.1
unnamed: R32.2, R34.1
unnamed: R33.2, R35.1
unnamed: R34.2, R38.1
unnamed: R35.2, R39.1
unnamed: R38.2, R40.1
unnamed: R39.2, R42.1
unnamed: R47.1, R48.2, U10.1
unnamed: R49.2, U12.2
unnamed: R50.2, U11.2
unnamed: R93.2, U2.4 (DT)
unnamed: R25.2, RV1.1, U4.4 (FB)
unnamed: R26.2, RV2.1, U5.4 (FB)
unnamed: TP3.1, U9.1, U9.2 (-), U9.5 (+)
unnamed: R45.1, R46.2, U9.6 (-)
unnamed: U10.2, U12.1
unnamed: R63.1, R65.2, U14.3 (+)
unnamed: RV3.2, U14.6 (-)
unnamed: C59.2, R17.1, R87.2, U20.3 (+)
unnamed: C58.2, R21.1, R23.2, U20.2 (-)
unnamed: C55.1, R9.2, R15.2, U21.2 (IN)
unnamed: R17.2, U21.7 (OUT+)
unnamed: R21.2, U21.6 (OUT-)
unnamed: R92.2, U22.4 (DT)
Ready: J9.4, K3.3, R66.1
Relay: C41.2, D24.1 (K), D27.1 (K), K3.6, K4.2
Timer: R62.1, R63.2, R69.1, TP5.1, U14.7
VS1_Out: C15.2, J11.5, U22.11 (VS)
VS2: C8.2, C11.2, H6.1, J16.5, Q5.3 (S), Q6.2 (D), Q7.3 (S), Q8.2 (D), R13.1, R19.1
VS2_Out: C18.2, J14.5, U2.11 (VS)
V_Out: C58.1, J17.4, R23.1, U20.1
gnd: C2.2, C3.2, C5.2, C6.2, C7.2, C9.2, C10.2, C12.2, C13.2, C14.2, C16.1, C17.1, C19.2, C20.2, C22.2, C24.2, C25.2, C26.2, C28.2, C29.2, C31.2, C32.2, C33.2, C42.2, C46.1, C47.1, C48.2, C50.2, C55.2, C56.2, C62.2, C63.2, D12.2 (A), D14.2 (A), D16.1 (K), D20.1 (K), D21.2 (A), H8.1, J11.2, J11.4, J11.6, J14.2, J14.4, J14.6, J15.2, J15.4, J15.6, J16.2, J16.4, J16.6, JP2.2 (B), K2.2, PS1.2 (-VIN), PS2.2 (-VIN), Q2.3 (S), Q4.3 (S), Q6.3 (S), Q8.3 (S), R6.1, R12.1, R14.1, R15.1, R20.1, R26.1, R37.1, R41.1, R43.1, R49.1, R92.1, R93.1, U2.3 (VSS), U2.5 (COM), U3.1 (GND), U5.3 (GND), U5.5 (~ON/OFF), U9.4 (V-), U13.3 (0V), U15.5 (VEE), U16.1 (GND), U17.5 (VEE), U21.3 (IN-), U21.4 (GND1), U22.3 (VSS), U22.5 (COM)
